robot7942/update_4wheel_crawler/upgrade_crawler/fusion_hardware/前輪クローラー_駆動モーター_連結部.step

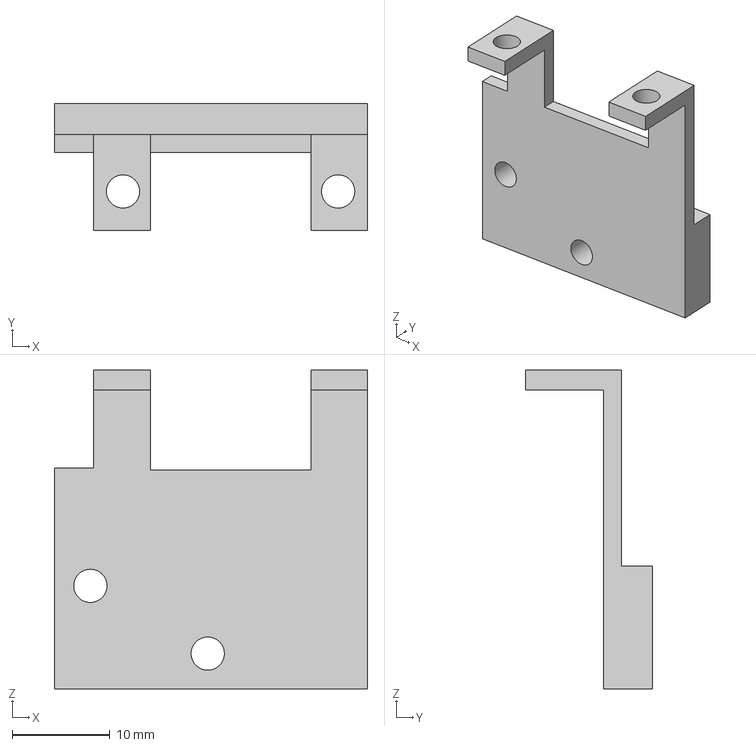
[picture p2: CAD file, 2026-11-06]
upgrade_crawler/fusion_hardware/前輪クローラー_駆動モーター_連結部.step
32.0 x 13.0 x 32.6 mm
