robot7942/update_4wheel_crawler/upgrade_crawler/fusion_hardware/車体_小型サーボSG90用.step

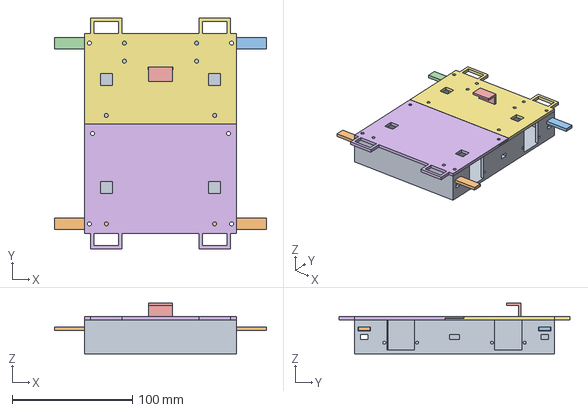
[picture p3: CAD file, 2026-11-06]
upgrade_crawler/fusion_hardware/車体_小型サーボSG90用.step
176.0 x 192.0 x 42.0 mm
