robot7942/update_4wheel_crawler/upgrade_crawler/fusion_hardware/クローラー_ガイド歯車_大.step

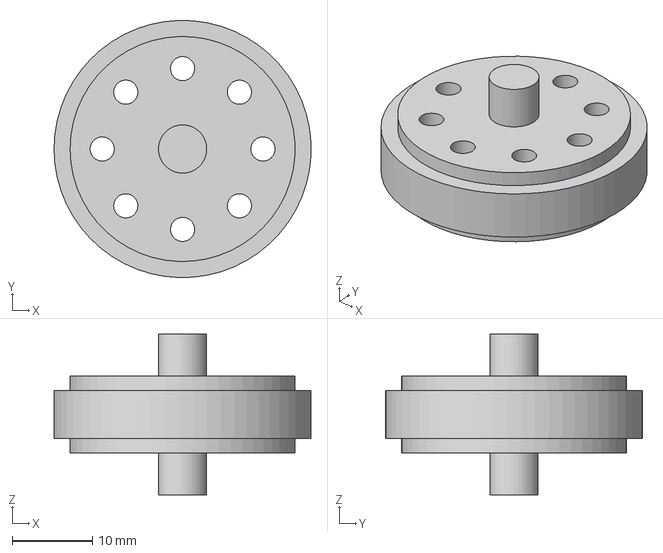
[picture p4: CAD file, 2026-11-06]
upgrade_crawler/fusion_hardware/クローラー_ガイド歯車_大.step
32.0 x 32.0 x 20.0 mm
