robot7942/update_4wheel_crawler/upgrade_crawler/fusion_hardware/車高調整用アーム.step

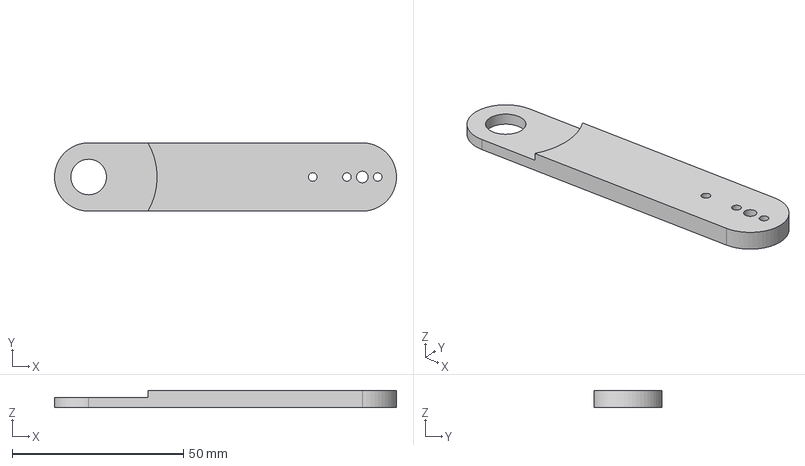
[picture p5: CAD file, 2026-11-06]
upgrade_crawler/fusion_hardware/車高調整用アーム.step
100.0 x 20.0 x 5.00 mm
