robot7942/update_4wheel_crawler/upgrade_crawler/fusion_hardware/駆動用モーターN20_マウント.step

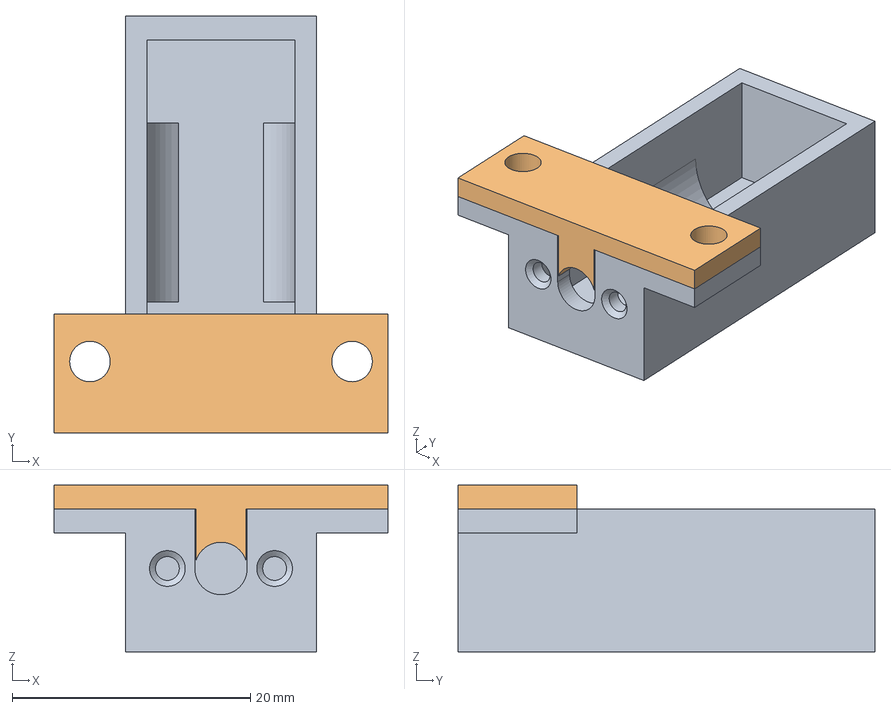
[picture p6: CAD file, 2026-11-06]
upgrade_crawler/fusion_hardware/駆動用モーターN20_マウント.step
28.0 x 35.0 x 14.0 mm
