robot7942/update_4wheel_crawler/upgrade_crawler/fusion_hardware/クローラー_動力歯車.step

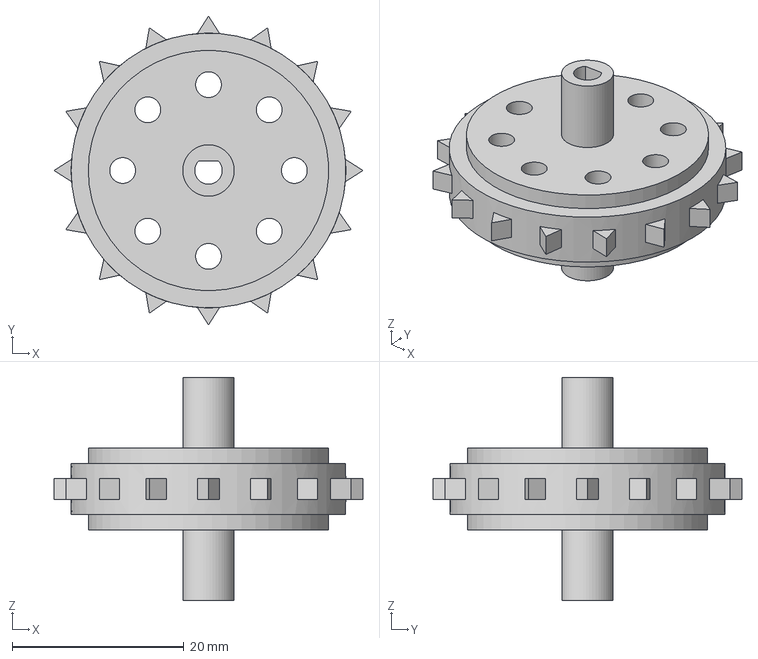
[picture p7: CAD file, 2026-11-06]
upgrade_crawler/fusion_hardware/クローラー_動力歯車.step
36.0 x 36.0 x 26.0 mm
