robot7942/update_4wheel_crawler/upgrade_crawler/fusion_hardware/クローラー_ガイド歯車_小.step

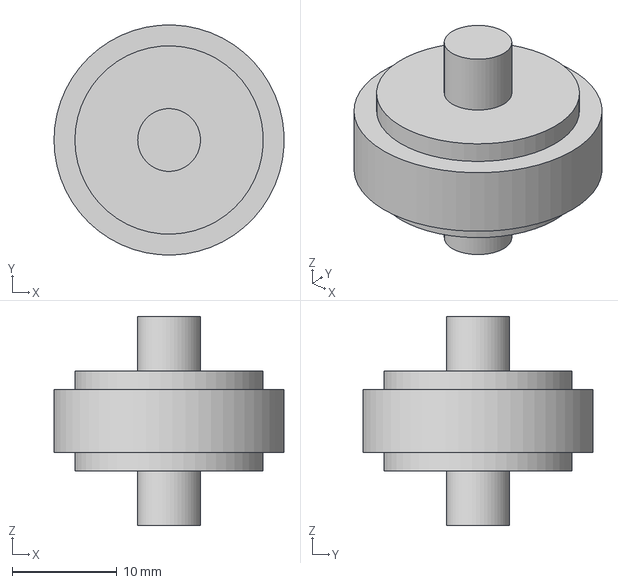
[picture p8: CAD file, 2026-11-06]
upgrade_crawler/fusion_hardware/クローラー_ガイド歯車_小.step
22.0 x 22.0 x 20.0 mm
