robot7942/update_4wheel_crawler/upgrade_crawler/fusion_hardware/後輪クローラーガイド.step

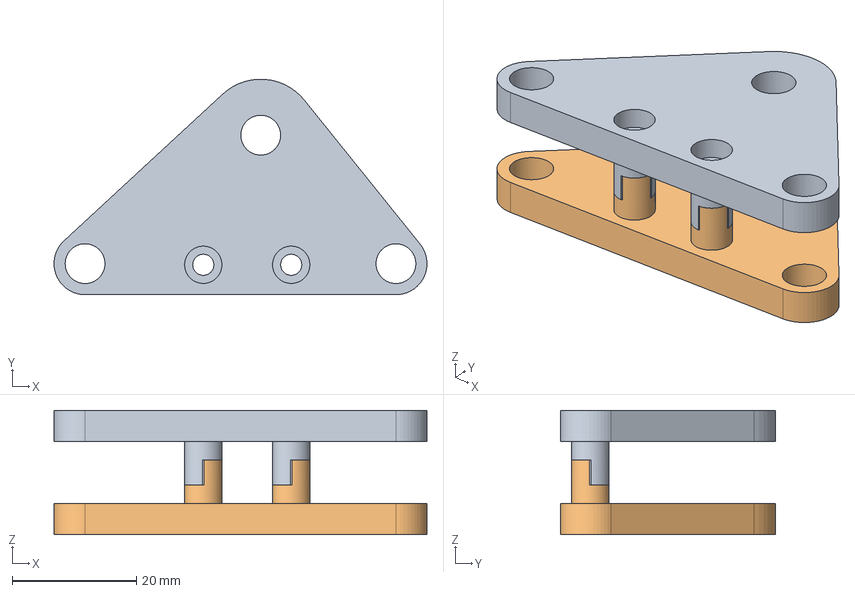
[picture p9: CAD file, 2026-11-06]
upgrade_crawler/fusion_hardware/後輪クローラーガイド.step
60.0 x 34.7 x 20.0 mm
