robot7942/update_4wheel_crawler/upgrade_crawler/fusion_hardware/前輪クローラーガイド.step

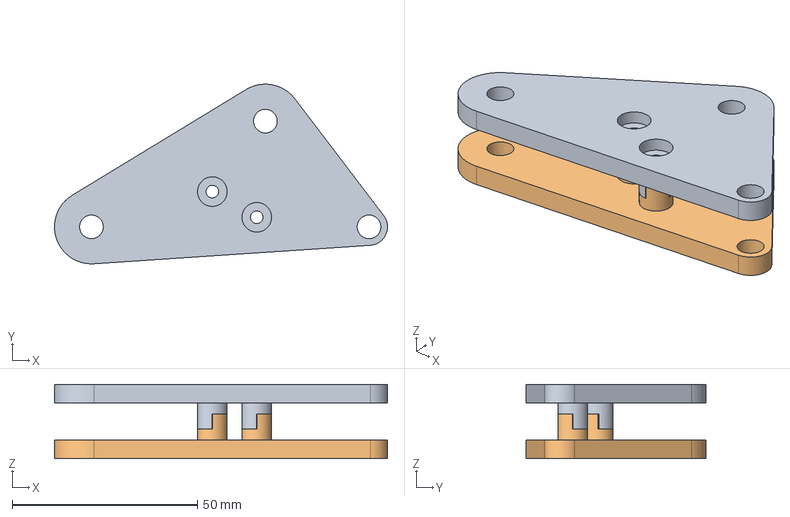
[picture p10: CAD file, 2026-11-06]
upgrade_crawler/fusion_hardware/前輪クローラーガイド.step
90.0 x 48.5 x 20.0 mm
