robot7942/update_4wheel_crawler/(list of files, cad)

Other CAD files:
upgrade_crawler/fusion_hardware/車高調整用アーム_SG90用.step
